Aurora-0110/fpga-multimedia-billboard/docs/design/r04/03_review/public_caption.png

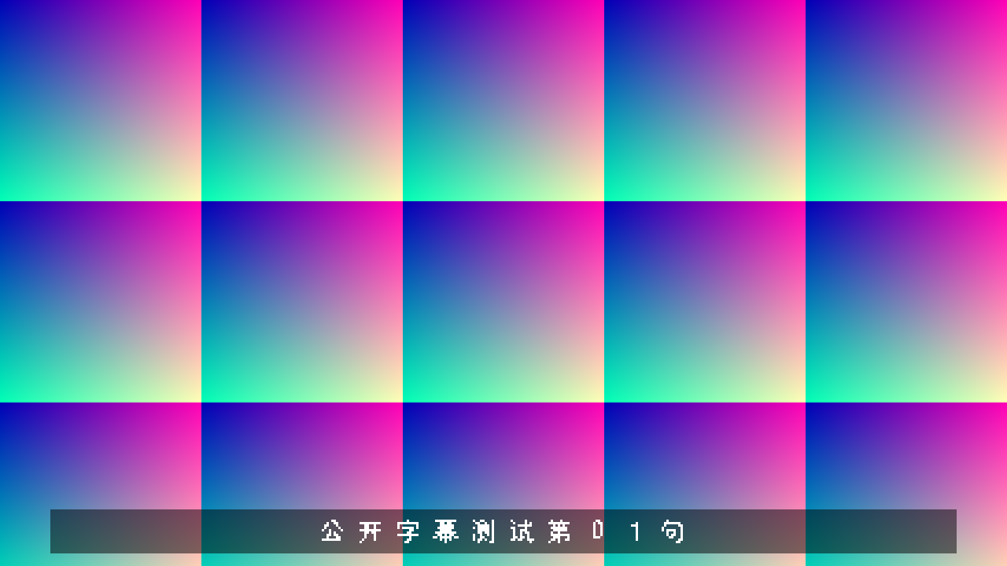
docs/design/r04/03_review/public_caption.png
