Aurora-0110/fpga-multimedia-billboard/03_bitstreams/README.md

# 位流说明

已验收的原始V132位流和Flash包保留在本地完整归档，不公开含原歌词、私有素材ROM或媒体衍生内容的二进制。公开仓库提供全部功能RTL、引脚约束、构建入口和可重建的自编字幕示例。请使用合法取得的TD和许可证生成自己的位流；更换字幕及Logo示例ROM后位流哈希与原验收位流不同，不沿用原实物验收。
