Aurora-0110/fpga-multimedia-billboard/05_td/README.md

# 原已验收配置的报告

本目录数值报告来自原 V132 配置，LUT17739、REG10676、BRAM9K61、DSP17；建立+0.667ns、保持+0.021ns。

公开版只改嵌入示例字幕与Logo数据；本目录不是对公开示例重新布局布线的结果。新构建的资源、时序与位流须依其新报告判断。包含媒体初始化的原网表/数据库/bit不公开。
