Aurora-0110/fpga-multimedia-billboard/docs/design/r04/README_修订与提交说明.md

# V132 r04 修订说明

- 原作品最终功能测试、Flash固化与冷启动：用户2026-10-31明确确认通过。
- 保持页面几何、页眉页脚、图像位置、公式及国标著录/上角标/交叉引用体系。
- 原TF实拍和歌词截图替换为用户验收记录示意及自编公开字幕真实RTL仿真输出，保留对应图片尺寸位置；不把示意图冒称实拍。
- 工程公开开源，TF素材不公开。全部功能算法与构建/测试入口公开；嵌入素材换成自编示例，不继承原位流的实物验收。
- 专项仪器测量和厂商签核没有由“功能通过”推断或补造。
- 全部旧版本保留；本次不改已固化位流、不写TF/Flash、不改网络。
