Aurora-0110/fpga-multimedia-billboard/THIRD_PARTY_NOTICES.md

# 许可与来源

1. **自研代码**：Aurora-0110，2026，MIT（根 LICENSE）。不把第三方权利重新授予为自有权利。
2. **HDMI 参考**：Sameer Puri / hdl-util/hdmi，原始源码与 MIT、Apache-2.0 文本保存在 `07_reference/hdl_util_hdmi`。本工程包/BCH 适配代码按文件头标注来源，保留原署名与适用许可。
3. **Noto CJK**：SIL Open Font License 1.1，源字体及固定提交信息见 `07_reference/fonts/noto_cjk`。生成的字体数据不被重新声明为无条件独占自研素材。
4. **ChillRound 圆体**：SIL Open Font License 1.1，v1.805，见 `07_reference/fonts/chill_round`，保留 LICENSE 和 SOURCE.json。
5. **厂商接口与板级资料**：Anlogic 原语的实现/仿真库、TD 软件、商业许可证、厂商原始 PDF 和安装器不分发。公开板级包装与约束以实际 NG88/24 MHz 条件为准；厂商资料仅作为设计参考，不由本工程转授其文档或商标权。
6. **TF 素材**：原图片、歌曲、广告、歌词、字幕稿与时间轴，以及嵌入其内容的原位流/数据库和截图不公开。不能用 MIT LICENSE 代替素材授权。
7. **公开替代数据**：公开测试字幕及自绘 FPGA 图案为工程自编示例，可按 CC0-1.0 使用；字体本身仍依 OFL。设计文档中的赛事标识/厂商名称仅作识别，原权利归相应权利人。
8. **历史**：新公开仓库从干净导出创建，没有把原含素材的 Git 历史对象推送到公开仓库。全部原工程、原位流及失败证据在本地冻结档案保留。
