Aurora-0110/fpga-multimedia-billboard/04_evidence/public_logo_20261031_203028/REVIEW.md

# 首次Logo TB失败说明

首个地址前 y 在声明时已为0，传统 always @* 行ROM在仿真初始事件未建立参考值，导致第一个参考像素为X；同步ROM为0。修改TB初始坐标为末地址，使第一笔地址确实变化后比较。未修改DUT算法或ROM数据。失败日志保留，后续独立summary给出重跑结果。
