Aurora-0110/fpga-multimedia-billboard/04_evidence/v132_ui_20261031_201750/v132_ui_2.png

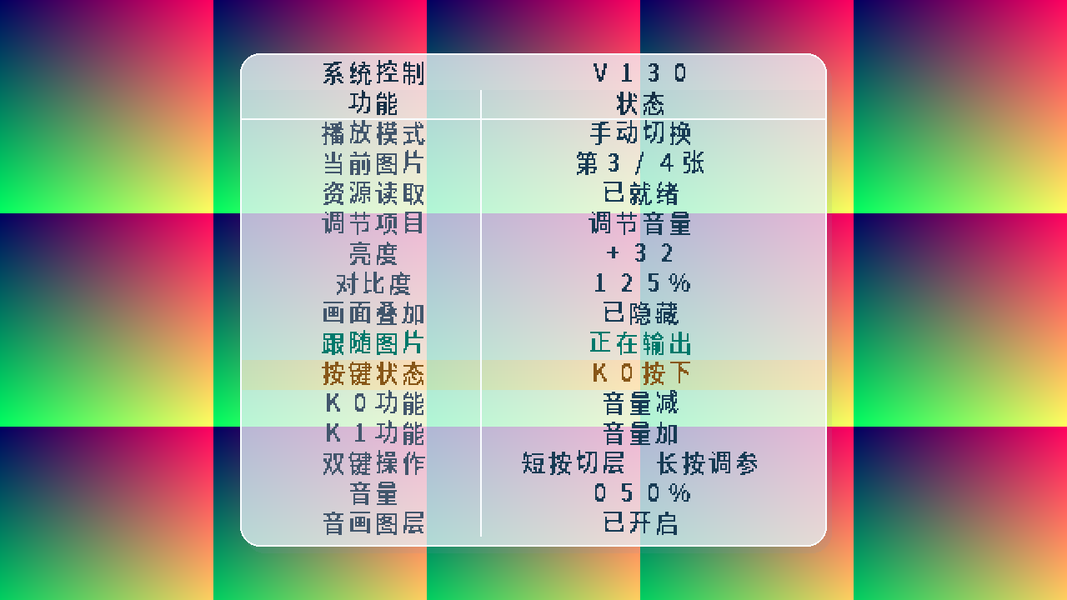
04_evidence/v132_ui_20261031_201750/v132_ui_2.png
