Aurora-0110/fpga-multimedia-billboard/docs/design/r04/03_review/contact_sheet.png

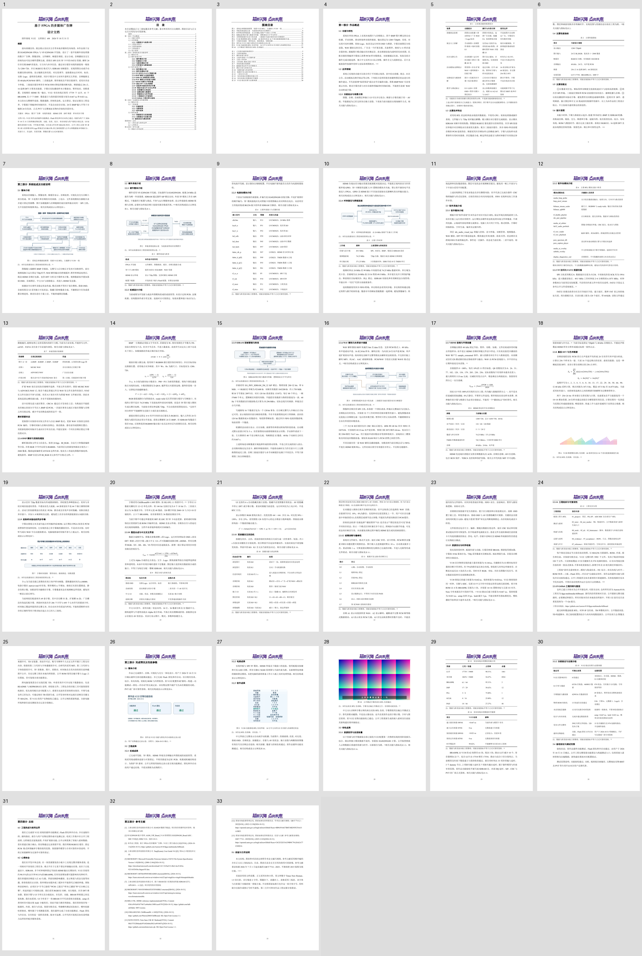
docs/design/r04/03_review/contact_sheet.png
