Aurora-0110/fpga-multimedia-billboard/docs/design/r04/03_review/page-22.png

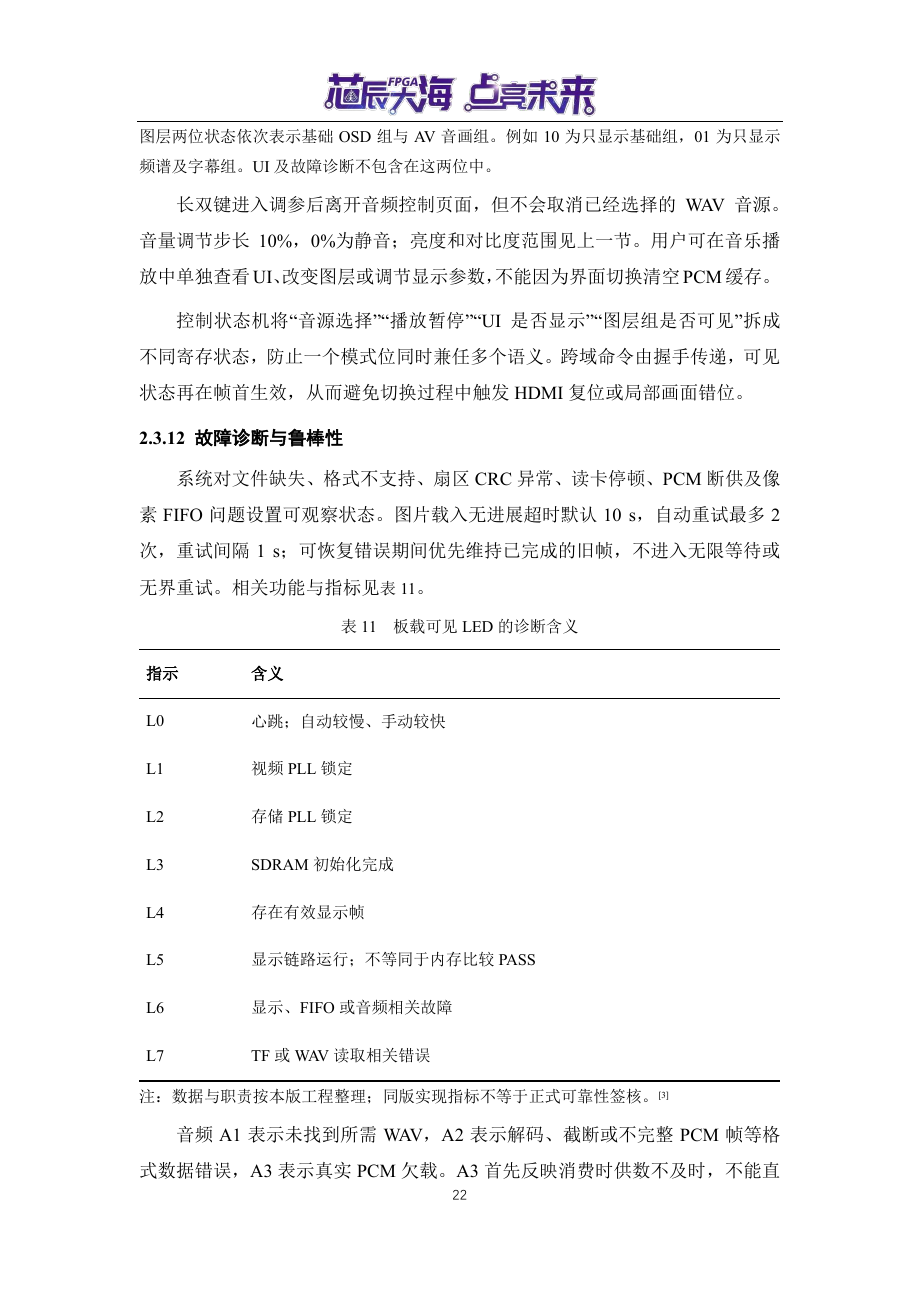
docs/design/r04/03_review/page-22.png
