Aurora-0110/fpga-multimedia-billboard/docs/design/r04/03_review/page-25.png

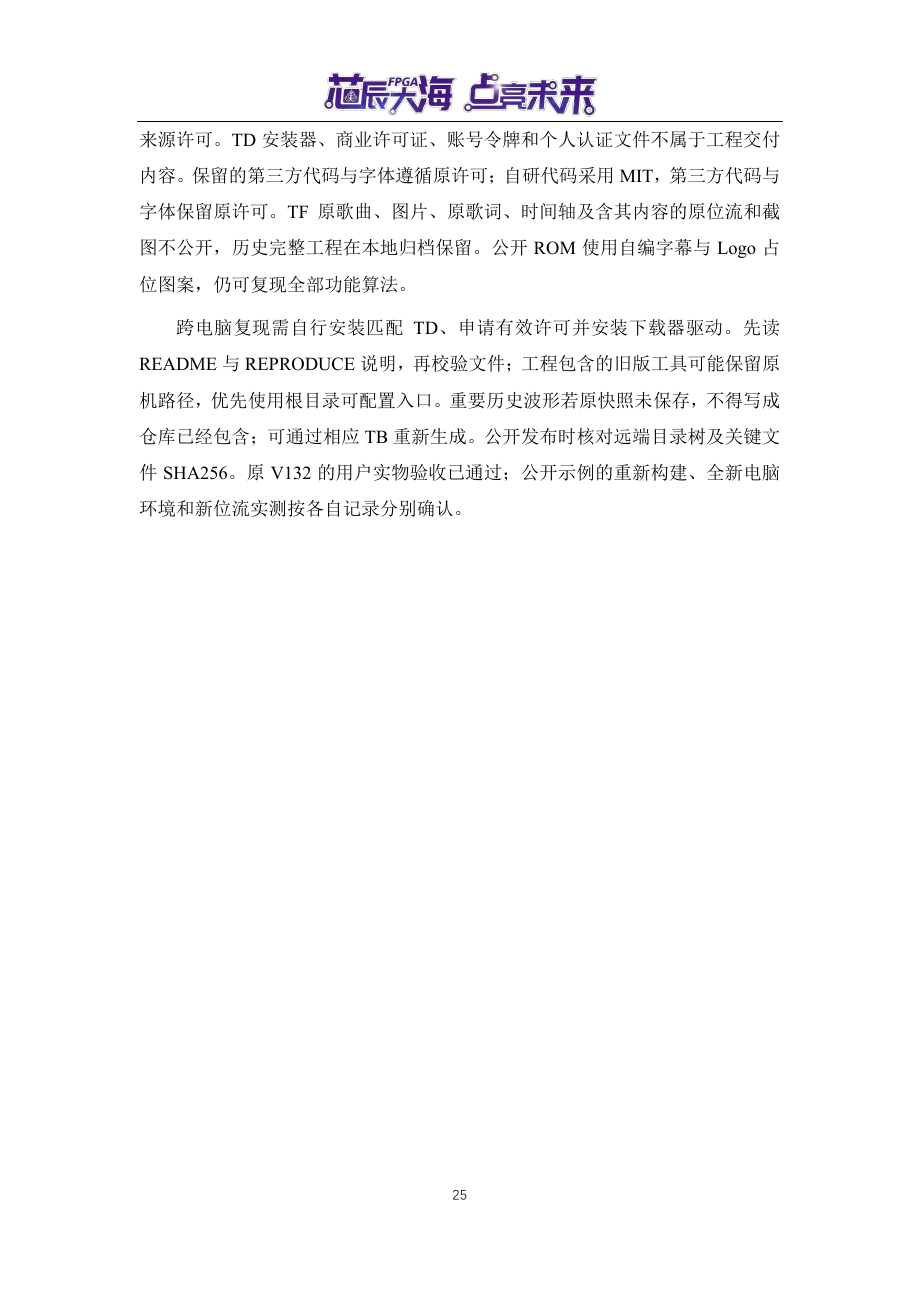
docs/design/r04/03_review/page-25.png
