Aurora-0110/fpga-multimedia-billboard/02_tests/README_PUBLIC.md

# 公开测试入口

源代码与TB保留原相对结构。推荐使用根tools/reproduce.py的font、controls、ui、captions四项已验证便携回归。历史测试入口可能引用旧私有夹具，应先按生成器建立对应自备夹具，不能宣称每个历史脚本都开箱通过。

厂商专有原语仿真库和授权不明的SDRAM模型不再分发；完整板级SDRAM模型仿真需从合法安装的TD及器件厂商取得。当前四项公开回归不依赖复制这些商业库。

另有logo公开替代数据回归：8192地址的组合/同步/紧凑ROM等价及一拍延迟检查通过。
