Aurora-0110/fpga-multimedia-billboard/01_project/rtl/video/official_logo.v

`timescale 1ns/1ps
// PUBLIC self-authored FPGA demo artwork; original TF image is not included.
module official_logo(input wire[6:0]x,input wire[5:0]y,output wire[1:0]pixel);
 reg[223:0]rowbits;
 always @* begin case(y)
6'd0:rowbits=224'h00000000000000000000000000000000000000000000000000000000;
6'd1:rowbits=224'h00000000000000000000000000000000000000000000000000000000;
6'd2:rowbits=224'h00000000000000000000000000000000000000000000000000000000;
6'd3:rowbits=224'h00000000000000000000000000000000000000000000000000000000;
6'd4:rowbits=224'h00000555555555555555555555555555555555555555555555500000;
6'd5:rowbits=224'h00005555555555555555555555555555555555555555555555550000;
6'd6:rowbits=224'h00055555555555555555555555555555555555555555555555555000;
6'd7:rowbits=224'h00155000000000000000000000000000000000000000000000055400;
6'd8:rowbits=224'h00150000000000000000000000000000000000000000000000005400;
6'd9:rowbits=224'h00540000000000000000000000000000000000000000000000001500;
6'd10:rowbits=224'h00540000000000000000000000000000000000000000000000001500;
6'd11:rowbits=224'h01500000000000000000000000000000000000000000000000000540;
6'd12:rowbits=224'h01500000000000000000000000000000000000000000000000000540;
6'd13:rowbits=224'h01500000000000000000000000000000000000000000000000000540;
6'd14:rowbits=224'h01500000000000000000000000000000000000000000000000000540;
6'd15:rowbits=224'h01500000000000000000000000000000000000000000000000000540;
6'd16:rowbits=224'h01500000000000000550000155500000155550155555000000000540;
6'd17:rowbits=224'h01500000000000001550000555540001555550155555000000000540;
6'd18:rowbits=224'h01500000000000001550001555550005550550055555000000000540;
6'd19:rowbits=224'h01500000000000001450000500154005400150000015000000000540;
6'd20:rowbits=224'h01500000000000005454000000055015400150000015000000000540;
6'd21:rowbits=224'h01500000000000005454000000015015400150000015000000000540;
6'd22:rowbits=224'h01500000000000005414000000015415400150000015000000000540;
6'd23:rowbits=224'h01500000000000015015000000015405400150000015000000000540;
6'd24:rowbits=224'h01500000000000015015000000015405540150055555000000000540;
6'd25:rowbits=224'h01500000000000015015001554005401555550055555000000000540;
6'd26:rowbits=224'h01500000000000055015401554015400555550015555000000000540;
6'd27:rowbits=224'h01500000000000055555401500015400000550000015000000000540;
6'd28:rowbits=224'h01500000000000055555401500015000000150000015000000000540;
6'd29:rowbits=224'h01500000000000154001501500055000000150000015000000000540;
6'd30:rowbits=224'h01500000000000150001501500154000000150000015000000000540;
6'd31:rowbits=224'h01500000000000150001501555554000000150000015000000000540;
6'd32:rowbits=224'h01500000000000550000541555550000000150000015000000000540;
6'd33:rowbits=224'h01500000000000540000540155500000000150000015000000000540;
6'd34:rowbits=224'h01500000000000000000000000000000000000000000000000000540;
6'd35:rowbits=224'h01500000000000000000000000000000000000000000000000000540;
6'd36:rowbits=224'h01500000000000000000000000000000000000000000000000000540;
6'd37:rowbits=224'h01500000000000000000000000000000000000000000000000000540;
6'd38:rowbits=224'h01500000000000000000000000000000000000000000000000000540;
6'd39:rowbits=224'h01500000000000000000000000000000000000000000000000000540;
6'd40:rowbits=224'h01500000000000000000000000000000000000000000000000000540;
6'd41:rowbits=224'h01500000000000000000000000000000000000000000000000000540;
6'd42:rowbits=224'h015000000002aaaaaaaaaaaaaaaaaaaaaaaaaaaaaaaa800000000540;
6'd43:rowbits=224'h015000000002aaaaaaaaaaaaaaaaaaaaaaaaaaaaaaaa800000000540;
6'd44:rowbits=224'h015000000002aaaaaaaaaaaaaaaaaaaaaaaaaaaaaaaa800000000540;
6'd45:rowbits=224'h00540000000000000000000000000000000000000000000000001500;
6'd46:rowbits=224'h00540000000000000000000000000000000000000000000000001500;
6'd47:rowbits=224'h00150000000000000000000000000000000000000000000000005400;
6'd48:rowbits=224'h00155000000000000000000000000000000000000000000000055400;
6'd49:rowbits=224'h00055555555555555555555555555555555555555555555555555000;
6'd50:rowbits=224'h00005555555555555555555555555555555555555555555555550000;
6'd51:rowbits=224'h00000555555555555555555555555555555555555555555555500000;
6'd52:rowbits=224'h00000000000000000000000000000000000000000000000000000000;
6'd53:rowbits=224'h00000000000000000000000000000000000000000000000000000000;
6'd54:rowbits=224'h00000000000000000000000000000000000000000000000000000000;
6'd55:rowbits=224'h00000000000000000000000000000000000000000000000000000000;
default:rowbits=0;endcase end
 assign pixel=x<112?((rowbits>>(x*2))&2'b11):2'b00;
endmodule

module official_logo_sync(input wire clk,input wire[6:0]x,input wire[5:0]y,output wire[1:0]pixel);
 reg[223:0]rowbits;
 reg[6:0]xpos;
 always @(posedge clk)begin xpos<=x;case(y)
6'd0:rowbits<=224'h00000000000000000000000000000000000000000000000000000000;
6'd1:rowbits<=224'h00000000000000000000000000000000000000000000000000000000;
6'd2:rowbits<=224'h00000000000000000000000000000000000000000000000000000000;
6'd3:rowbits<=224'h00000000000000000000000000000000000000000000000000000000;
6'd4:rowbits<=224'h00000555555555555555555555555555555555555555555555500000;
6'd5:rowbits<=224'h00005555555555555555555555555555555555555555555555550000;
6'd6:rowbits<=224'h00055555555555555555555555555555555555555555555555555000;
6'd7:rowbits<=224'h00155000000000000000000000000000000000000000000000055400;
6'd8:rowbits<=224'h00150000000000000000000000000000000000000000000000005400;
6'd9:rowbits<=224'h00540000000000000000000000000000000000000000000000001500;
6'd10:rowbits<=224'h00540000000000000000000000000000000000000000000000001500;
6'd11:rowbits<=224'h01500000000000000000000000000000000000000000000000000540;
6'd12:rowbits<=224'h01500000000000000000000000000000000000000000000000000540;
6'd13:rowbits<=224'h01500000000000000000000000000000000000000000000000000540;
6'd14:rowbits<=224'h01500000000000000000000000000000000000000000000000000540;
6'd15:rowbits<=224'h01500000000000000000000000000000000000000000000000000540;
6'd16:rowbits<=224'h01500000000000000550000155500000155550155555000000000540;
6'd17:rowbits<=224'h01500000000000001550000555540001555550155555000000000540;
6'd18:rowbits<=224'h01500000000000001550001555550005550550055555000000000540;
6'd19:rowbits<=224'h01500000000000001450000500154005400150000015000000000540;
6'd20:rowbits<=224'h01500000000000005454000000055015400150000015000000000540;
6'd21:rowbits<=224'h01500000000000005454000000015015400150000015000000000540;
6'd22:rowbits<=224'h01500000000000005414000000015415400150000015000000000540;
6'd23:rowbits<=224'h01500000000000015015000000015405400150000015000000000540;
6'd24:rowbits<=224'h01500000000000015015000000015405540150055555000000000540;
6'd25:rowbits<=224'h01500000000000015015001554005401555550055555000000000540;
6'd26:rowbits<=224'h01500000000000055015401554015400555550015555000000000540;
6'd27:rowbits<=224'h01500000000000055555401500015400000550000015000000000540;
6'd28:rowbits<=224'h01500000000000055555401500015000000150000015000000000540;
6'd29:rowbits<=224'h01500000000000154001501500055000000150000015000000000540;
6'd30:rowbits<=224'h01500000000000150001501500154000000150000015000000000540;
6'd31:rowbits<=224'h01500000000000150001501555554000000150000015000000000540;
6'd32:rowbits<=224'h01500000000000550000541555550000000150000015000000000540;
6'd33:rowbits<=224'h01500000000000540000540155500000000150000015000000000540;
6'd34:rowbits<=224'h01500000000000000000000000000000000000000000000000000540;
6'd35:rowbits<=224'h01500000000000000000000000000000000000000000000000000540;
6'd36:rowbits<=224'h01500000000000000000000000000000000000000000000000000540;
6'd37:rowbits<=224'h01500000000000000000000000000000000000000000000000000540;
6'd38:rowbits<=224'h01500000000000000000000000000000000000000000000000000540;
6'd39:rowbits<=224'h01500000000000000000000000000000000000000000000000000540;
6'd40:rowbits<=224'h01500000000000000000000000000000000000000000000000000540;
6'd41:rowbits<=224'h01500000000000000000000000000000000000000000000000000540;
6'd42:rowbits<=224'h015000000002aaaaaaaaaaaaaaaaaaaaaaaaaaaaaaaa800000000540;
6'd43:rowbits<=224'h015000000002aaaaaaaaaaaaaaaaaaaaaaaaaaaaaaaa800000000540;
6'd44:rowbits<=224'h015000000002aaaaaaaaaaaaaaaaaaaaaaaaaaaaaaaa800000000540;
6'd45:rowbits<=224'h00540000000000000000000000000000000000000000000000001500;
6'd46:rowbits<=224'h00540000000000000000000000000000000000000000000000001500;
6'd47:rowbits<=224'h00150000000000000000000000000000000000000000000000005400;
6'd48:rowbits<=224'h00155000000000000000000000000000000000000000000000055400;
6'd49:rowbits<=224'h00055555555555555555555555555555555555555555555555555000;
6'd50:rowbits<=224'h00005555555555555555555555555555555555555555555555550000;
6'd51:rowbits<=224'h00000555555555555555555555555555555555555555555555500000;
6'd52:rowbits<=224'h00000000000000000000000000000000000000000000000000000000;
6'd53:rowbits<=224'h00000000000000000000000000000000000000000000000000000000;
6'd54:rowbits<=224'h00000000000000000000000000000000000000000000000000000000;
6'd55:rowbits<=224'h00000000000000000000000000000000000000000000000000000000;
default:rowbits<=0;endcase end
 assign pixel=xpos<112?((rowbits>>(xpos*2))&2'b11):2'b00;
endmodule
