Aurora-0110/fpga-multimedia-billboard/01_project/rtl/visual/official_logo_compact_sync.v

`timescale 1ns/1ps
// PUBLIC self-authored FPGA demo artwork; original TF image is not included.
module official_logo_compact_sync(input wire clk,input wire[6:0]x,input wire[5:0]y,output reg[1:0]pixel);
 (* ram_style="bram" *)reg[1:0]memory[0:8191];
 wire[12:0]address={y,x};
 initial begin
memory[0]=2'd0;
memory[1]=2'd0;
memory[2]=2'd0;
memory[3]=2'd0;
memory[4]=2'd0;
memory[5]=2'd0;
memory[6]=2'd0;
memory[7]=2'd0;
memory[8]=2'd0;
memory[9]=2'd0;
memory[10]=2'd0;
memory[11]=2'd0;
memory[12]=2'd0;
memory[13]=2'd0;
memory[14]=2'd0;
memory[15]=2'd0;
memory[16]=2'd0;
memory[17]=2'd0;
memory[18]=2'd0;
memory[19]=2'd0;
memory[20]=2'd0;
memory[21]=2'd0;
memory[22]=2'd0;
memory[23]=2'd0;
memory[24]=2'd0;
memory[25]=2'd0;
memory[26]=2'd0;
memory[27]=2'd0;
memory[28]=2'd0;
memory[29]=2'd0;
memory[30]=2'd0;
memory[31]=2'd0;
memory[32]=2'd0;
memory[33]=2'd0;
memory[34]=2'd0;
memory[35]=2'd0;
memory[36]=2'd0;
memory[37]=2'd0;
memory[38]=2'd0;
memory[39]=2'd0;
memory[40]=2'd0;
memory[41]=2'd0;
memory[42]=2'd0;
memory[43]=2'd0;
memory[44]=2'd0;
memory[45]=2'd0;
memory[46]=2'd0;
memory[47]=2'd0;
memory[48]=2'd0;
memory[49]=2'd0;
memory[50]=2'd0;
memory[51]=2'd0;
memory[52]=2'd0;
memory[53]=2'd0;
memory[54]=2'd0;
memory[55]=2'd0;
memory[56]=2'd0;
memory[57]=2'd0;
memory[58]=2'd0;
memory[59]=2'd0;
memory[60]=2'd0;
memory[61]=2'd0;
memory[62]=2'd0;
memory[63]=2'd0;
memory[64]=2'd0;
memory[65]=2'd0;
memory[66]=2'd0;
memory[67]=2'd0;
memory[68]=2'd0;
memory[69]=2'd0;
memory[70]=2'd0;
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
memory[6310]=2'd1;
memory[6311]=2'd1;
memory[6312]=2'd1;
memory[6313]=2'd1;
memory[6314]=2'd1;
memory[6315]=2'd1;
memory[6316]=2'd1;
memory[6317]=2'd1;
memory[6318]=2'd1;
memory[6319]=2'd1;
memory[6320]=2'd1;
memory[6321]=2'd1;
memory[6322]=2'd1;
memory[6323]=2'd1;
memory[6324]=2'd1;
memory[6325]=2'd1;
memory[6326]=2'd1;
memory[6327]=2'd1;
memory[6328]=2'd1;
memory[6329]=2'd1;
memory[6330]=2'd1;
memory[6331]=2'd1;
memory[6332]=2'd1;
memory[6333]=2'd1;
memory[6334]=2'd1;
memory[6335]=2'd1;
memory[6336]=2'd1;
memory[6337]=2'd1;
memory[6338]=2'd1;
memory[6339]=2'd1;
memory[6340]=2'd1;
memory[6341]=2'd1;
memory[6342]=2'd1;
memory[6343]=2'd1;
memory[6344]=2'd1;
memory[6345]=2'd1;
memory[6346]=2'd1;
memory[6347]=2'd1;
memory[6348]=2'd1;
memory[6349]=2'd1;
memory[6350]=2'd1;
memory[6351]=2'd1;
memory[6352]=2'd1;
memory[6353]=2'd1;
memory[6354]=2'd1;
memory[6355]=2'd1;
memory[6356]=2'd1;
memory[6357]=2'd1;
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
