Aurora-0110/fpga-multimedia-billboard/01_project/rtl/tf/tf_bus_scaled_loader.v

`timescale 1ns/1ps
// Load-side integration only. done waits for source validation, scaler drain,
// and REGISTERED acceptance of the last coordinate-addressed SDRAM burst.
module tf_bus_scaled_loader #(
 parameter RUNTIME_NAME=1,HALF_DIV=124,DATA_HALF_DIV=HALF_DIV,
 POWER_WAIT_CYCLES=4950000,INIT_GAP_CYCLES=49500,
 OUT_WIDTH=1280,OUT_HEIGHT=720,MAX_WIDTH=1280,MAX_HEIGHT=1024,DITHER_ENABLE=0
)(
 input wire [7:0] file_letter,input wire clk,rst_n,enable,
 input wire ready,read_done,dv,input wire [3:0] se,input wire [8:0] di,input wire [7:0] db,
 output wire read_req,output wire [31:0] read_lba,
 output wire [31:0] mount_base,mount_fat,mount_max,mount_root,output wire [7:0] mount_spc,output wire [3:0] mount_shift,
 output wire req_valid,output wire [18:0] req_addr,output wire [127:0] req_data,
 input wire req_ack,output wire done,output wire [7:0] error_code,
 output wire mounted,bmp_ok
);
 wire pv,pr,sdone,sok;wire [23:0] rgb;wire [15:0] x,y;wire [7:0] err;
 tf_bus_bmp_scaled_source #(.RUNTIME_NAME(RUNTIME_NAME),.HALF_DIV(HALF_DIV),.DATA_HALF_DIV(DATA_HALF_DIV),
 .POWER_WAIT_CYCLES(POWER_WAIT_CYCLES),.INIT_GAP_CYCLES(INIT_GAP_CYCLES),
 .OUT_WIDTH(OUT_WIDTH),.OUT_HEIGHT(OUT_HEIGHT),.MAX_WIDTH(MAX_WIDTH),.MAX_HEIGHT(MAX_HEIGHT)) source(
 .clk(clk),.rst_n(rst_n),.file_letter(file_letter),.ready(ready),.read_done(read_done),.dv(dv),.se(se),.di(di),.db(db),.read_req(read_req),.read_lba(read_lba),
 .mount_base(mount_base),.mount_fat(mount_fat),.mount_max(mount_max),.mount_root(mount_root),.mount_spc(mount_spc),.mount_shift(mount_shift),
 .pixel_valid(pv),.pixel_ready(pr),.pixel_rgb(rgb),.pixel_x(x),.pixel_y(y),
 .done(sdone),.ok(sok),.error_code(err),.mounted(mounted),.bmp_ok(bmp_ok),
 .source_width(),.source_height(),.row_stride(),.source_pixel_count(),.payload_crc32());
 bmp_pixel_packer #(.WIDTH(OUT_WIDTH),.HEIGHT(OUT_HEIGHT),.DITHER_ENABLE(DITHER_ENABLE)) packer(
 .clk(clk),.rst_n(rst_n),.enable(enable),.pixel_valid(pv),.pixel_ready(pr),
 .pixel_rgb(rgb),.pixel_x(x),.pixel_y(y),.source_done(sdone),.source_ok(sok),.source_error(err),
 .req_valid(req_valid),.req_addr(req_addr),.req_data(req_data),.req_ack(req_ack),
 .done(done),.error_code(error_code),.pixel_count(),.burst_count());
endmodule
