Aurora-0110/fpga-multimedia-billboard/02_tests/audio_visual/tb_v130_top.sv

`timescale 1ns/1ps
// Adapted from v081 top test for the real pair display; constant paired FIFO injection.
// Clock/lock substitutes and an undriven SDRAM shell: only top control wiring tested.
module pll_sdram(input clk_in,rst_n,output clk_sd,clk_24,locked);
 reg sd=0;always #10.101 sd=~sd;
 assign clk_sd=sd;assign clk_24=clk_in;assign locked=rst_n;
endmodule
module EG_PHY_SDRAM_2M_32(input clk,ras_n,cas_n,we_n,input [10:0]addr,input [1:0]ba,
 inout [31:0]dq,input cs_n,dm0,dm1,dm2,dm3,cke);
endmodule
module tb_visual_top;
 reg clk24m=0,key0_n=1,key1_n=1;always #20.833333 clk24m=~clk24m;
 wire tf_cs_n,tf_sck,tf_mosi,led_sclk,led_dout,led_latch,hdmi_clk_p;wire[2:0]hdmi_d_p;
 idx_audio_visual_top #(.START_BITS(4),.KEY_CNT(4),.UI_HOLD_CYCLES(40)) dut(
 .clk24m(clk24m),.key0_n(key0_n),.key1_n(key1_n),.tf_miso(1'b1),
 .tf_cs_n(tf_cs_n),.tf_sck(tf_sck),.tf_mosi(tf_mosi),.led_sclk(led_sclk),.led_dout(led_dout),.led_latch(led_latch),.hdmi_clk_p(hdmi_clk_p),.hdmi_d_p(hdmi_d_p));
 reg crst=0,tf=0,tw=0,empty=0;reg[12:0]used=0;
 integer checks=0,epochs=0;reg monitor=0;reg expected;
 always @(posedge dut.pix) if(monitor)begin
  expected=dut.diag_visible;#0.1;
  if(!dut.rp || !dut.hdmi.rst_n)$fatal(1,"content event reset HDMI");
  if(dut.hdmi.picture_q!==expected)$fatal(1,"picture gate not aligned with RGB register");
  if(dut.hdmi.audio.packets.audio_enable!==dut.hdmi.picture_q)$fatal(1,"packet gate disconnected");
  if(dut.hdmi.HDMI_AUDIO_GATE_ENABLE!=1)$fatal(1,"production gate parameter disabled");
  checks=checks+1;
 end
 integer retries=0,modes=0;
 always @(posedge dut.sd)begin if(dut.retry)retries++;if(dut.mode_press)modes++;end
 task tick(input integer n);repeat(n)@(negedge dut.pix);endtask
 task state(input bit want);begin
  tick(40);
  if(dut.picture_visible!==want || dut.hdmi.picture_q!==want)$fatal(1,"visibility/gate expected %b",want);
  if(dut.win_d && dut.screen_rgb !== (want?24'hff0000:24'h0))$fatal(1,"screen masking expected %b rgb=%h",want,dut.screen_rgb);
 end endtask
 initial begin
  // Real production display registers and top/wrapper. Only SDRAM/FIFO inputs,
  // content epoch reset and coordinate events are injected, NOT picture_visible.
  force dut.len=0;force dut.pipe.prst=crst;force dut.pipe.en=2'b11;
  force dut.pipe.fe=empty;force dut.pipe.ru=used;force dut.pipe.frd=24'h00e0e0;
  force dut.fs=tf;force dut.window=tw;force dut.edge_d=0;force dut.x=12'd500;force dut.y=12'd300;
  wait(dut.rp&&dut.rs);tick(2);monitor=1;
  state(0);
  repeat(3)begin
   crst=1;used=0;tw=1;state(0); // not yet frame-ready
   tw=0;used=4096;tf=1;tick(1);tf=0;state(0); // running, no real pixel
   tw=1;state(1); // first real pixel and gate high
   tw=0;state(1); // horizontal/vertical blanking must not mute
   crst=0;tw=1;state(0); // switch/restart does not reset HDMI
   epochs=epochs+1;
  end
  // A pair display must prime its registered local queue before frame_start.
  // Real video has blanking/frame boundaries; do not pulse it on reset release.
  crst=1;used=4096;tw=0;tick(12);tf=1;tick(1);tf=0;tw=1;state(1);
  force dut.active_osd_enabled=0;
  empty=1;state(0);
  if(dut.pipe.display.fault!==1)$fatal(1,"underflow not latched");
  // Independent banner after a REAL display underflow. Contents/audio remain
  // hidden, but the fault row is red and the HDMI timing must continue.
  force dut.de=1;force dut.x=20;force dut.y=10;tick(30);
  if(!dut.diagnostic_enable)$fatal(1,"hidden UI suppressed real underflow diagnosis");
  if(dut.diag_rgb!==24'h601020||!dut.diag_de||dut.diag_visible||dut.hdmi.picture_q)
   $fatal(1,"fault banner vanished or unmuted the audio gate");
  force dut.x=500;force dut.y=300;release dut.de;
  empty=0;state(0); // fault must not spontaneously resume tone
  crst=0;state(0);crst=1;tw=0;tick(12);tf=1;tick(1);tf=0;tw=1;state(1);
  release dut.active_osd_enabled;
  // Restore through the real frame-boundary commit after forcing the hidden test.
  force dut.x_d=0;force dut.y_d=0;tick(1);release dut.x_d;release dut.y_d;tick(8);
  // UI edits must not issue playlist actions; only frame start commits values.
  force dut.dd=1;force dut.x_d=12'd500;force dut.y_d=12'd300;
  // Short chord cycles independent base/AV requests; they commit at the
  // first active pixel, and does not change the framebuffer/audio visibility.
  key0_n=0;key1_n=0;tick(9);key0_n=1;key1_n=1;tick(16);
  if(!dut.ui_osd_enabled||dut.ui_av_enabled||!dut.active_osd_enabled||!dut.active_av_enabled||retries||modes)
   $fatal(1,"short chord leaked action or changed a layer mid-frame");
  force dut.x_d=0;force dut.y_d=0;tick(1);
  force dut.x_d=500;force dut.y_d=300;tick(20);
  if(!dut.active_osd_enabled||dut.active_av_enabled||!dut.hdmi.picture_q)$fatal(1,"hide OSD muted picture/audio");
  key0_n=0;key1_n=0;tick(80);key0_n=1;key1_n=1;tick(12);
  if(dut.ui_field!=1||!dut.ui_osd_enabled||!dut.active_osd_enabled||dut.ui_av_enabled||dut.active_av_enabled)$fatal(1,"long hold OSD field=%0d requested=%b active=%b state(session,held,chord,hold)=%b%b%b %0d",dut.ui_field,dut.ui_osd_enabled,dut.active_osd_enabled,dut.controls.session,dut.controls.held,dut.controls.chord,dut.controls.hold_count);
  key1_n=0;tick(12);key1_n=1;tick(12);
  if(dut.ui_brightness!=16||dut.active_brightness!=0)$fatal(1,"frame commit before first pixel");
  force dut.x_d=0;force dut.y_d=0;tick(1);
  force dut.x_d=500;force dut.y_d=300;tick(20);
  if(dut.active_brightness!=16||dut.overlay.shown_bright!=16||!dut.active_osd_enabled)$fatal(1,"frame commit/OSD snapshot");
  if(dut.adjusted_rgb!==24'hff1010)$fatal(1,"top pixel adjustment got %h",dut.adjusted_rgb);
  // Exit both editors (one hold per field) then exercise event CDC.
  repeat(3)begin key0_n=0;key1_n=0;tick(80);key0_n=1;key1_n=1;tick(12);end
  // Current state10: cycle01,00,11. Requests may not commit mid-frame.
  for(integer layer=1;layer>=-1;layer=layer-1)begin
   key0_n=0;key1_n=0;tick(9);key0_n=1;key1_n=1;tick(16);
   if({dut.ui_osd_enabled,dut.ui_av_enabled} !== (layer&3))$fatal(1,"layer cycle request");
   if({dut.active_osd_enabled,dut.active_av_enabled} !== ((layer+1)&3))$fatal(1,"layer changed mid-frame");
   force dut.x_d=0;force dut.y_d=0;tick(1);
   force dut.x_d=500;force dut.y_d=300;tick(20);
   if({dut.active_osd_enabled,dut.active_av_enabled} !== (layer&3)||!dut.hdmi.picture_q)$fatal(1,"layer commit muted framebuffer/audio");
  end
  key0_n=0;tick(12);key0_n=1;tick(16);
  key1_n=0;tick(12);key1_n=1;tick(16);
  if(retries!=1||modes!=1)$fatal(1,"playlist toggle CDC pulses retry%d mode%d",retries,modes);
  // ui_next/ui_mode are both 1. Memory-only reset must prime, not replay.
  force dut.l1=0;tick(10);release dut.l1;tick(24);
  if(retries!=1||modes!=1)$fatal(1,"replayed event after memory reset");
  if(!dut.rp)$fatal(1,"memory reset reset video");
  key0_n=0;tick(12);key0_n=1;tick(16);
  key1_n=0;tick(12);key1_n=1;tick(16);
  if(retries!=2||modes!=2)$fatal(1,"new actions lost after memory reset");
  // Source UI also resets on video loss; no trailing toggle may become a key.
  monitor=0;force dut.l2=0;tick(10);release dut.l2;wait(dut.rp);tick(30);monitor=1;
  if(retries!=2||modes!=2)$fatal(1,"phantom event after video reset");
  key0_n=0;tick(12);key0_n=1;tick(16);
  key1_n=0;tick(12);key1_n=1;tick(16);
  if(retries!=3||modes!=3)$fatal(1,"new actions lost after video reset");
  tick(150);
  // Actual new top wiring: long K0/long K1 must never cross as playlist events.
  key0_n=0;tick(90);key0_n=1;tick(16);
  if(!dut.ui_audio_select||retries!=3||modes!=3)$fatal(1,"top long K0 leaked image");
  key1_n=0;tick(12);key1_n=1;tick(16);
  if(dut.ui_audio_choice!=1||dut.selected_demo_track!=1||modes!=3)$fatal(1,"top selected demo mux/modal mode isolation");
  key1_n=0;tick(90);key1_n=1;tick(16);
  if(!dut.ui_toggle||!dut.help_ui.ui_toggle||modes!=3)$fatal(1,"top UI pin routing");
  key0_n=0;tick(12);key0_n=1;tick(16);
  if(!dut.ui_audio_select||!dut.ui_audio_paused||retries!=3||modes!=3||dut.ui_audio_choice!=1)
   $fatal(1,"top pause changed picture/choice or exited control");
  tick(50);
  if(!dut.pcm_source.paused||dut.help_ui.audio_status!=1)$fatal(1,"top pause/status routing");
  key0_n=0;tick(12);key0_n=1;tick(16);
  if(!dut.ui_audio_select||dut.ui_audio_paused||retries!=3||modes!=3)
   $fatal(1,"top resume leaked image/mode");
  // Only a long K0 exits this latched mode, preserving source and position.
  key0_n=0;tick(90);key0_n=1;tick(16);
  if(dut.ui_audio_select||dut.ui_audio_paused||retries!=3||modes!=3||dut.ui_audio_choice!=1)
   $fatal(1,"top long exit changed picture/choice/pause");
  // Verify actual top wiring: valid-zero samples must not trigger the bars.
  force dut.op=1;force dut.pcm_epoch=0;force dut.pcm_valid=1;
  force dut.pcm_left=0;force dut.pcm_right=0;tick(19202);
  if(dut.pcm_sound_active||dut.spectrum.sound_active)$fatal(1,"top valid-zero shown as sound");
  force dut.pcm_left=8192;tick(4);
  if(!dut.pcm_sound_active||!dut.spectrum.sound_active)$fatal(1,"top PCM activity wiring");
  force dut.pcm_left=0;tick(19199);if(!dut.pcm_sound_active)$fatal(1,"top quiet hold cut short");
  tick(1);if(dut.pcm_sound_active)$fatal(1,"top quiet hold did not end");
  release dut.op;release dut.pcm_epoch;release dut.pcm_valid;release dut.pcm_left;release dut.pcm_right;
  // Exercise the ACTUAL board wiring after a real long-K0 audio-control exit.
  force dut.dbg_error=0;force dut.help_sync=0;force dut.wav_error=0;force dut.wav_under=1;
  force dut.caption_x=0;force dut.caption_y=0;force dut.caption_de=1;tick(1);
  force dut.caption_x=1;force dut.caption_de=0;tick(48);
  if(dut.help_ui.tf_error!=0||dut.help_ui.audio_error!=8'ha3||dut.help_ui.shown_failed||
     dut.help_ui.shown_error!=0||dut.help_ui.shown_audio_error!=8'ha3||dut.help_ui.state_msg_cache[11]!=35||!dut.diagnostic_enable)
   $fatal(1,"top audio A3 mapped to image error/retry after exit");
  force dut.dbg_error=8'he0;
  force dut.caption_x=0;force dut.caption_de=1;tick(1);force dut.caption_x=1;force dut.caption_de=0;tick(48);
  if(!dut.help_ui.shown_failed||dut.help_ui.shown_error!=8'he0||dut.help_ui.shown_audio_error!=8'ha3||dut.help_ui.state_msg_cache[11]!=44)
   $fatal(1,"top simultaneous image/audio faults not separated");
  release dut.caption_x;release dut.caption_y;release dut.caption_de;
  release dut.dbg_error;release dut.help_sync;release dut.wav_error;release dut.wav_under;
  // Non-decorative diagnostics must survive each fault source even with UI OFF.
  force dut.active_osd_enabled=0;force dut.help_de=1;force dut.help_x=20;force dut.help_y=10;
  force dut.audio_fault=1;tick(20);
  if(!dut.diagnostic_enable||!dut.diagnostics.history[2]||dut.diag_rgb!==24'h601020||!dut.rp)
   $fatal(1,"hidden audio overflow fault not exposed");
  release dut.audio_fault;tick(8);force dut.of=1;tick(20);
  if(!dut.diagnostic_enable||!dut.diagnostics.history[1]||!dut.rp)$fatal(1,"hidden SDRAM writer overflow fault");
  release dut.of;tick(8);force dut.error_latched=8'he0;tick(20);
  if(!dut.diagnostic_enable||!dut.diagnostics.history[3]||dut.dbg_error!=8'he0||!dut.rp)$fatal(1,"hidden TF timeout fault");
  release dut.error_latched;tick(20);
  if(dut.diag_rgb!==24'h601020||!dut.rp)$fatal(1,"fault history hidden after automatic retry clears live error");
  release dut.help_de;release dut.help_x;release dut.help_y;release dut.active_osd_enabled;
  $display("PASS v130_visual_top independent-ui-toggle+pause-resume+long-modal-exit + hidden-fault-sources+history+ actual-PCM-activity+ first-real-pixel/top-RGB-mask/gate-alignment/blanking/restart/underflow/retry/independent-domain-reset epochs=%0d checks=%0d",epochs,checks);$finish;
 end
 initial begin #1500000;$fatal(1,"watchdog");end
endmodule
